rokeithu/-Ball-Sorting-Mechanical-Arm/FULLASSEMBLY.SLDASM

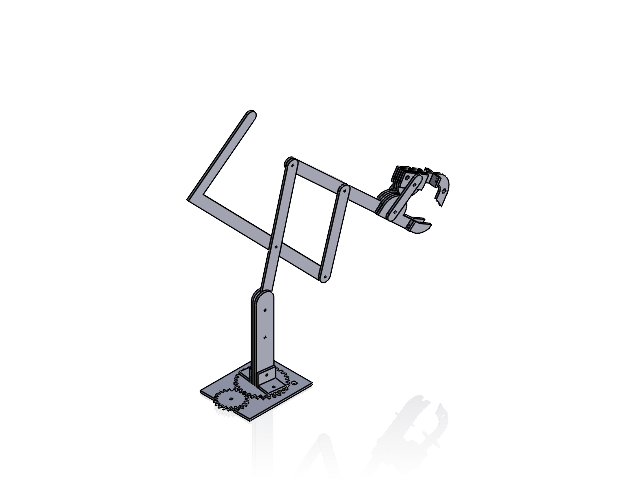
[picture p7: CAD file, 2025-09-13]
FULLASSEMBLY.SLDASM
Base
Gear
Arm Gear
skinny base x 2
skinny part 2
skinny part 3
skinny part 4
Skinny Part5 (2)
blockthing x 4
BottomClawLink
V2BottomClaw x 2
Gear Spacer x 4
TopClaw
V2BottomClawSpacer x 2
BracketOne x 2
TopClawLink
