rokeithu/-Ball-Sorting-Mechanical-Arm/(list of files, cad)

Other CAD files:
ARM TO BASE BLOCK.SLDDRW
ArmAssembly.SLDDRW
ArmToBase.SLDDRW
Base.SLDDRW
BaseAssembly.SLDDRW
BottomClawLink.SLDDRW
Claw.SLDDRW
ClawLinkage.SLDDRW
FourBarLinkageHandle.SLDDRW
FourBarLinkageOne.SLDDRW
FourBarLinkageToClam.SLDDRW
FourBarLinkageTwo.SLDDRW
GearOne.SLDDRW
GearTwo.SLDDRW
TopClaw.SLDDRW
TopClawLink.SLDDRW
V2BottomClaw.SLDDRW
V2BottomClawSpacer.SLDDRW
crank.SLDDRW
