rokeithu/-Ball-Sorting-Mechanical-Arm/ArmAssembly.pdf

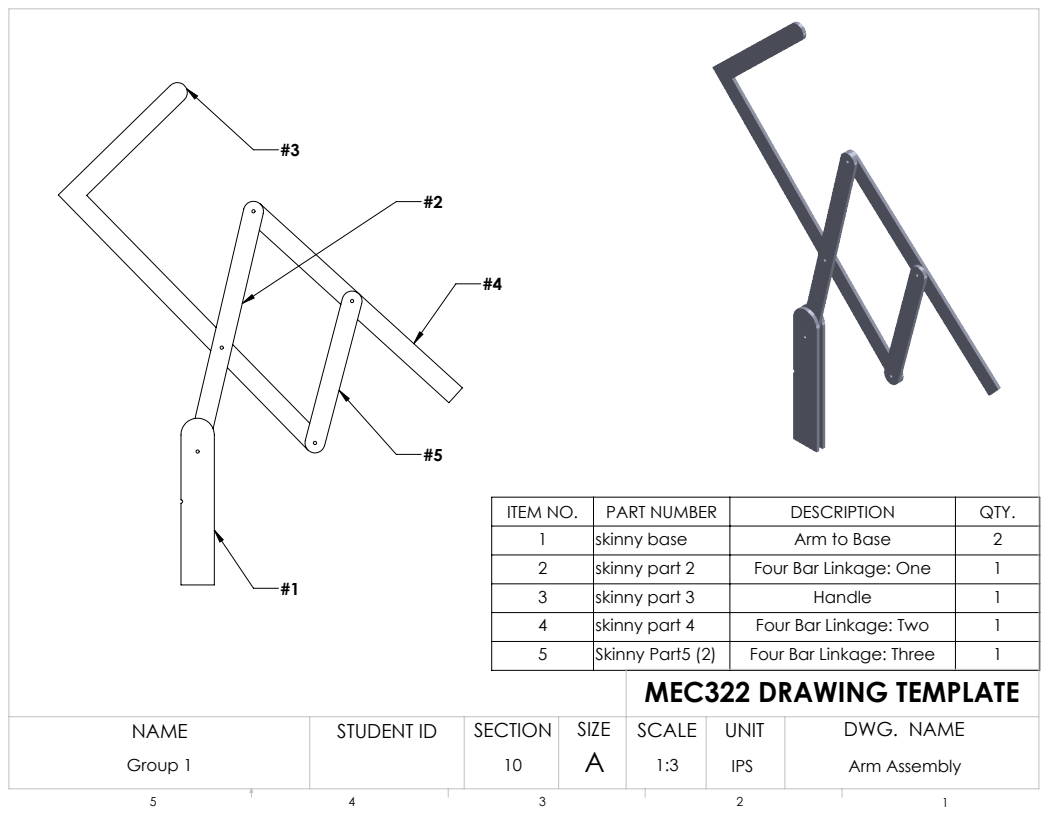
[picture p8: page 1]
MEC322 DRAWING TEMPLATE; NAME; STUDENT ID; SECTION; SCALE UNIT; DWG. NAME; Group 1; IPS; Arm Assembly

ITEM NO. | PART NUMBER | DESCRIPTION | QTY.
1 | skinny base | Arm to Base | 2
2 | skinny part 2 | Four Bar Linkage: One | 1
3 | skinny part 3 | Handle | 1
4 | skinny part 4 | Four Bar Linkage: Two | 1
5 | Skinny Part5 (2) | Four Bar Linkage: Three | 1
