rokeithu/-Ball-Sorting-Mechanical-Arm/BaseAssembly.pdf

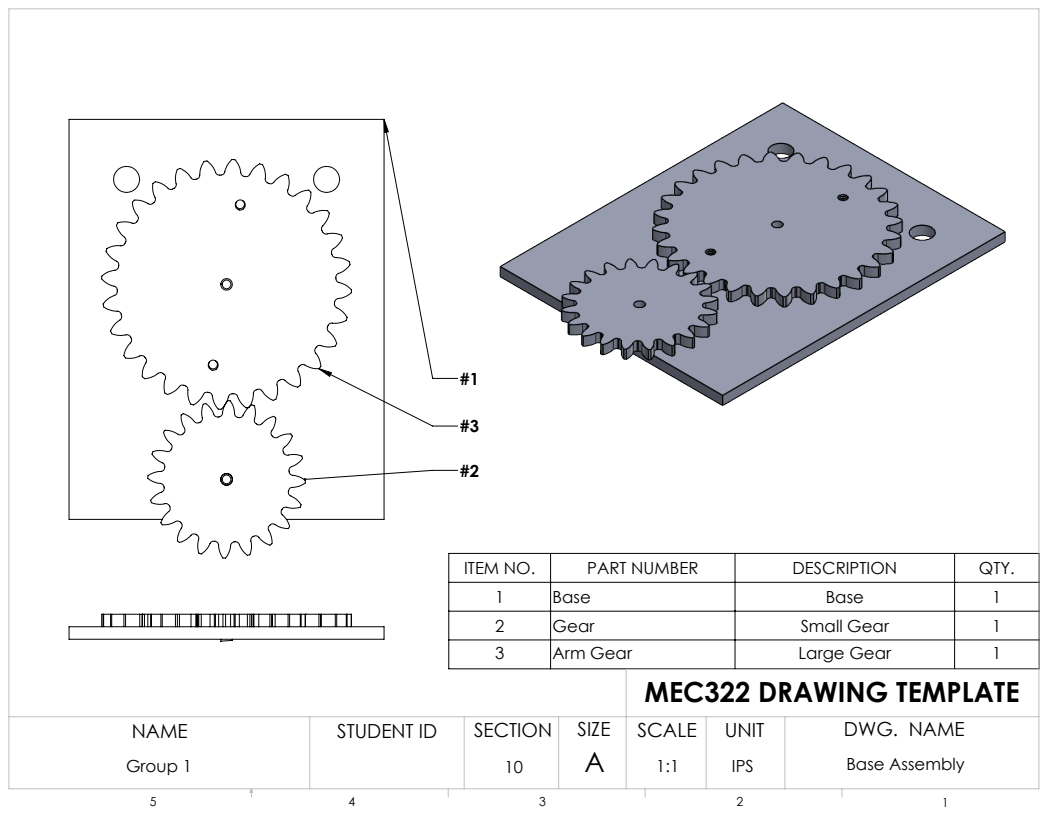
[picture p9: page 1]
MEC322 DRAWING TEMPLATE; NAME; STUDENT ID; SECTION; SCALE UNIT; DWG. NAME; Group 1; IPS; Base Assembly

ITEM NO. | PART NUMBER | DESCRIPTION | QTY.
1 | Base | Base | 1
2 | Gear | Small Gear | 1
3 | Arm Gear | Large Gear | 1
