rokeithu/-Ball-Sorting-Mechanical-Arm/BottomClawLink.pdf

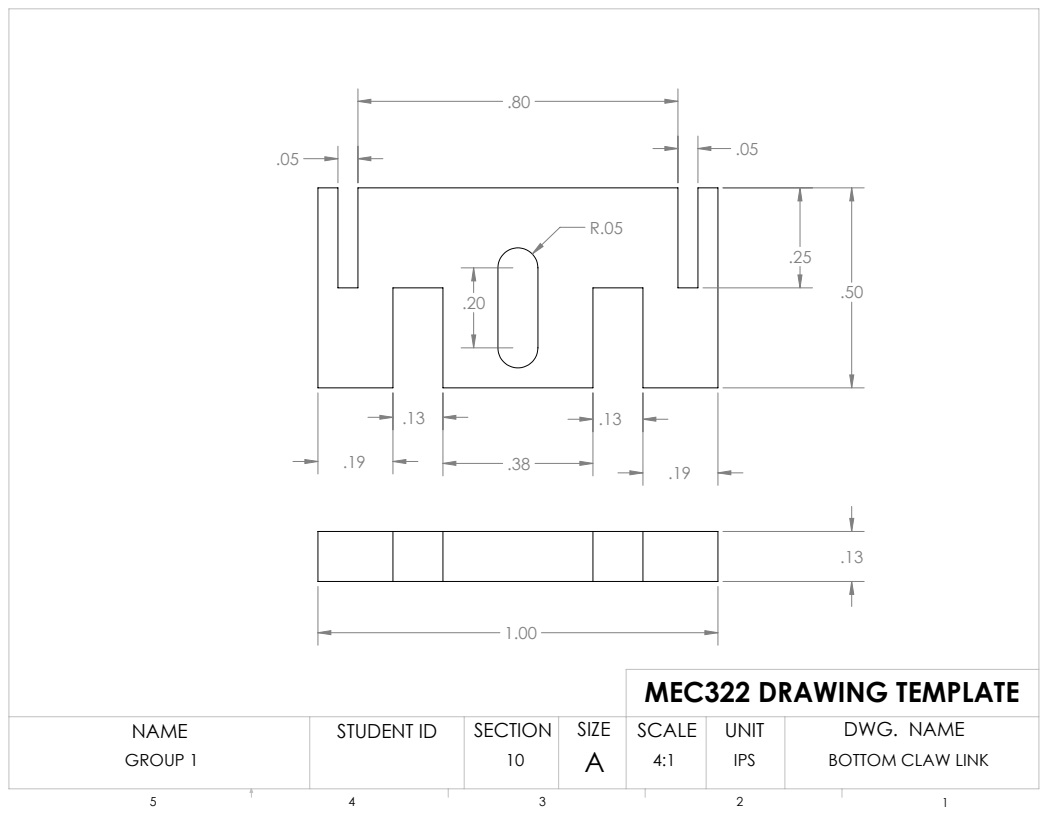
[picture p10: page 1]
MEC322 DRAWING TEMPLATE; NAME; STUDENT ID; SECTION; SCALE UNIT; DWG. NAME; GROUP 1; IPS; BOTTOM CLAW LINK
