rokeithu/-Ball-Sorting-Mechanical-Arm/ClawLinkage.pdf

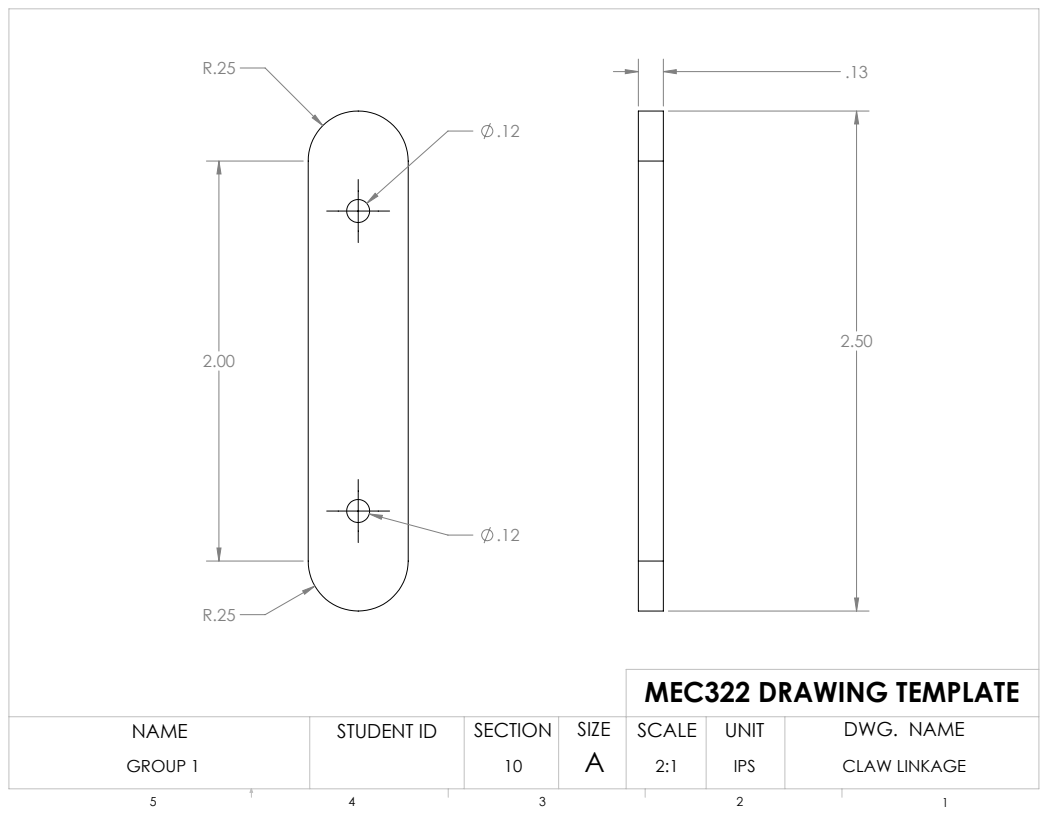
[picture p11: page 1]
MEC322 DRAWING TEMPLATE; NAME; STUDENT ID; SECTION; SCALE UNIT; DWG. NAME; GROUP 1; IPS; CLAW LINKAGE
