rokeithu/-Ball-Sorting-Mechanical-Arm/FourBarLinkageToClam.pdf

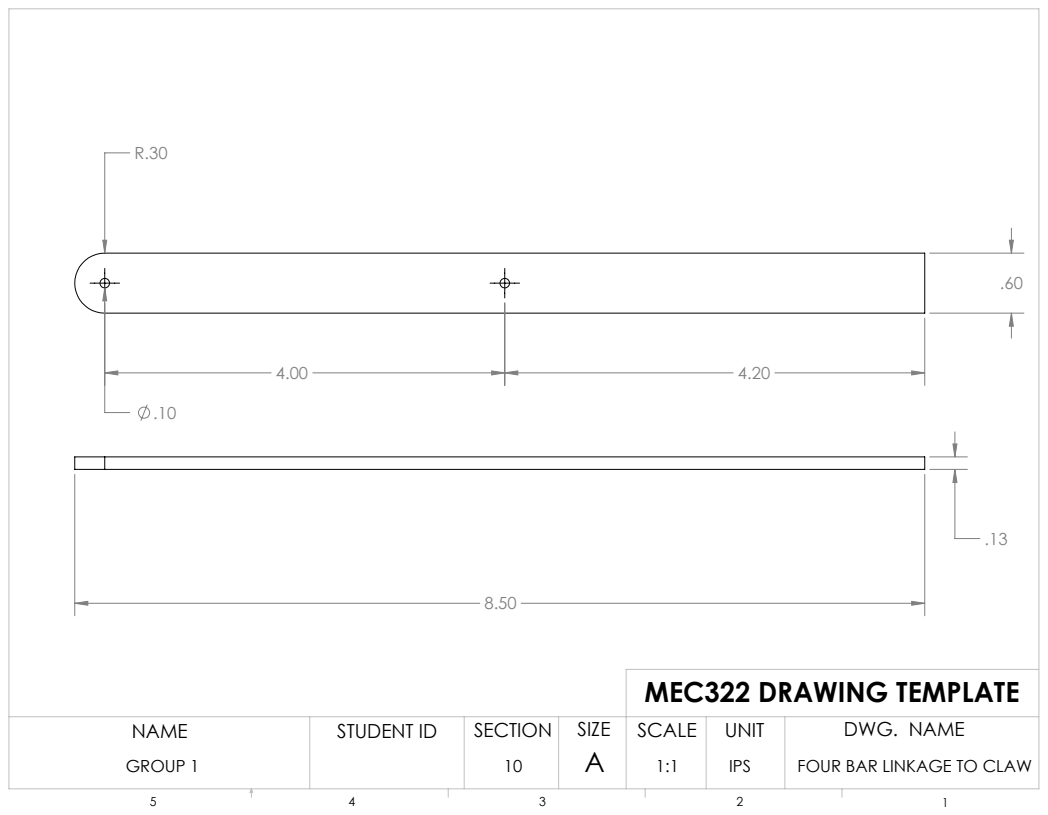
[picture p12: page 1]
MEC322 DRAWING TEMPLATE; NAME; STUDENT ID; SECTION; SCALE UNIT; DWG. NAME; GROUP 1; IPS; FOUR BAR LINKAGE TO CLAW
