rokeithu/-Ball-Sorting-Mechanical-Arm/GearOne.pdf

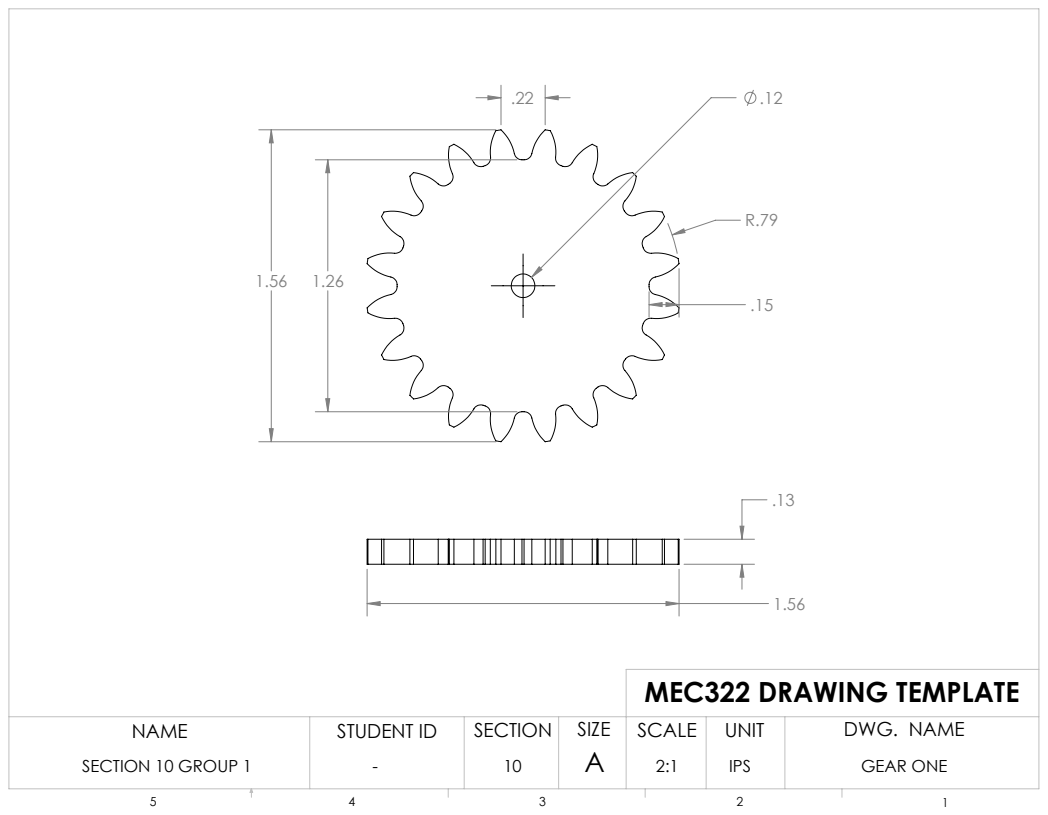
[picture p13: page 1]
MEC322 DRAWING TEMPLATE; NAME; STUDENT ID; SECTION; SCALE UNIT; DWG. NAME; SECTION 10 GROUP 1; IPS; GEAR ONE
