rokeithu/-Ball-Sorting-Mechanical-Arm/GearTwo.pdf

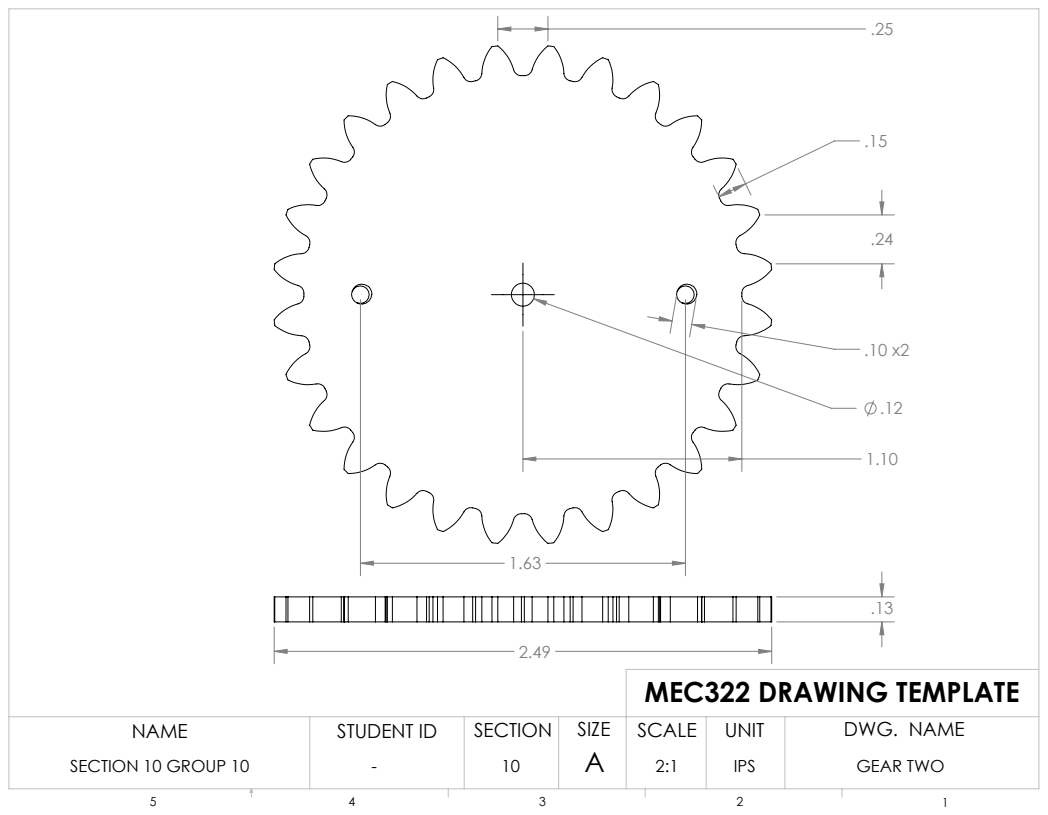
[picture p14: page 1]
MEC322 DRAWING TEMPLATE; NAME; STUDENT ID; SECTION; SCALE UNIT; DWG. NAME; SECTION 10 GROUP 10; IPS; GEAR TWO
