rokeithu/-Ball-Sorting-Mechanical-Arm/TopClaw.pdf

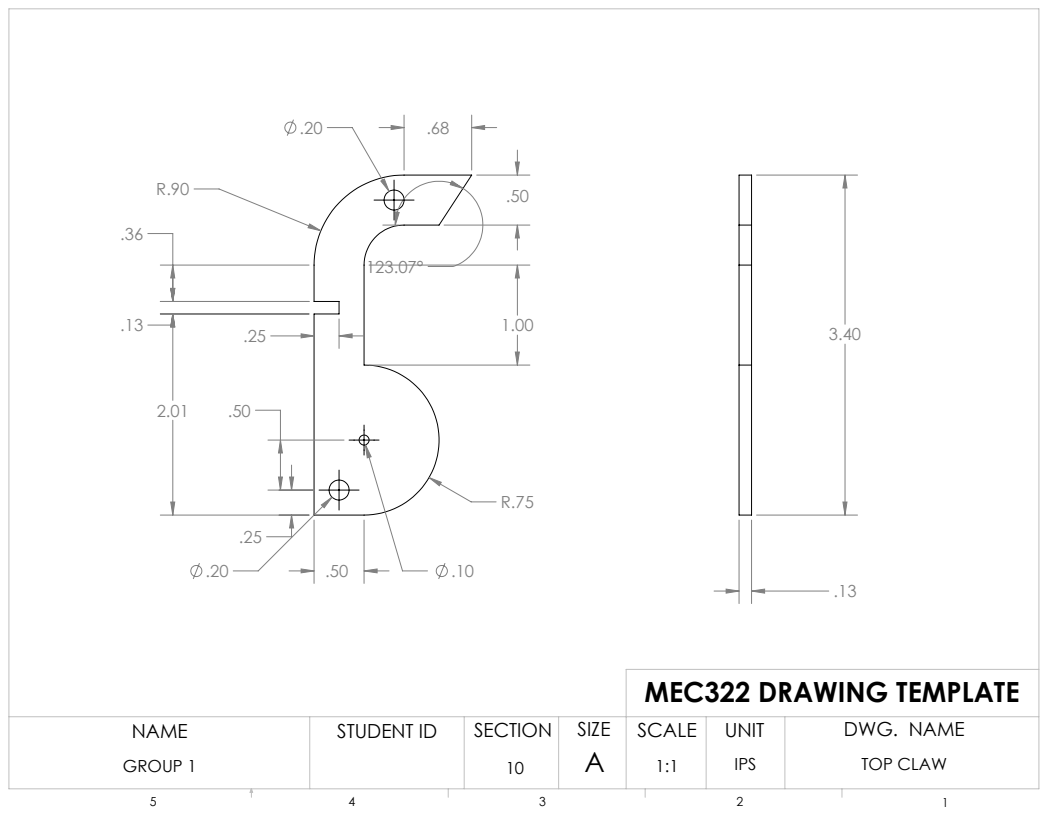
[picture p15: page 1]
MEC322 DRAWING TEMPLATE; NAME; STUDENT ID; SECTION; SCALE UNIT; DWG. NAME; GROUP 1; IPS; TOP CLAW
