rokeithu/-Ball-Sorting-Mechanical-Arm/Claw.pdf

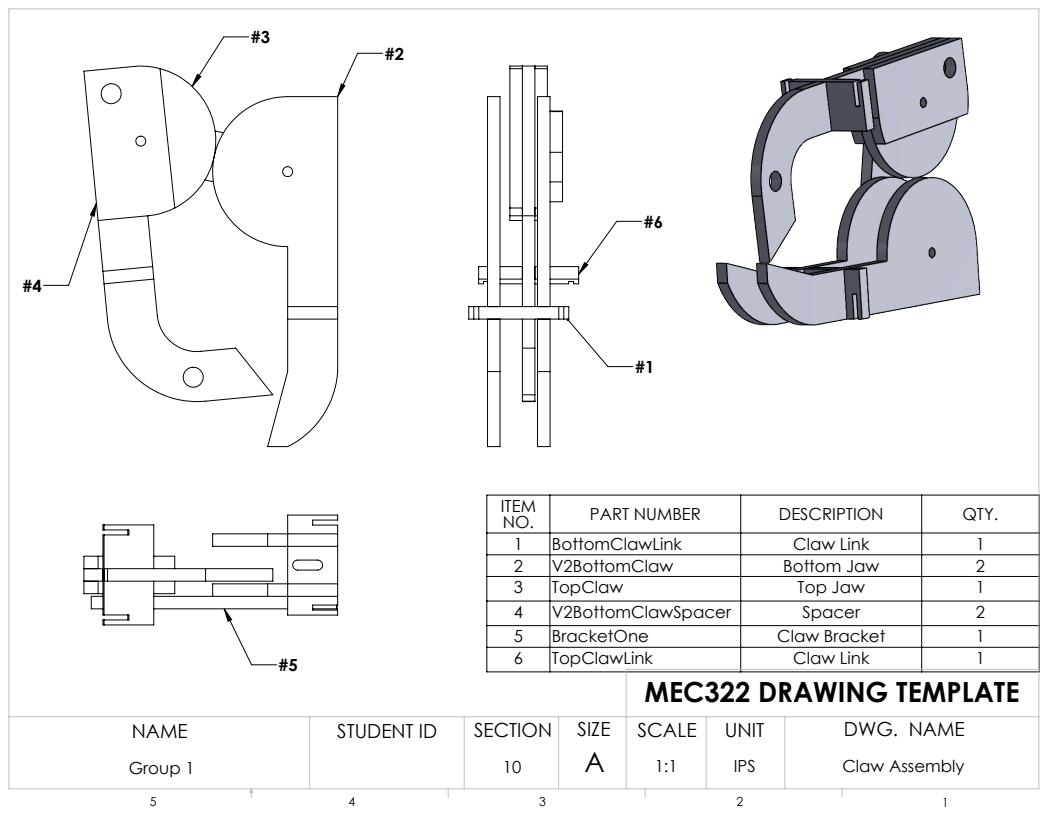
[picture p17: page 1]
MEC322 DRAWING TEMPLATE; NAME; STUDENT ID; SECTION; SCALE UNIT; DWG. NAME; Group 1; IPS; Claw Assembly

ITEM NO. | PART NUMBER | DESCRIPTION | QTY.
1 | BottomClawLink | Claw Link | 1
2 | V2BottomClaw | Bottom Jaw | 2
3 | TopClaw | Top Jaw | 1
4 | V2BottomClawSpacer | Spacer | 2
5 | BracketOne | Claw Bracket | 1
6 | TopClawLink | Claw Link | 1
