rokeithu/-Ball-Sorting-Mechanical-Arm/Base.pdf

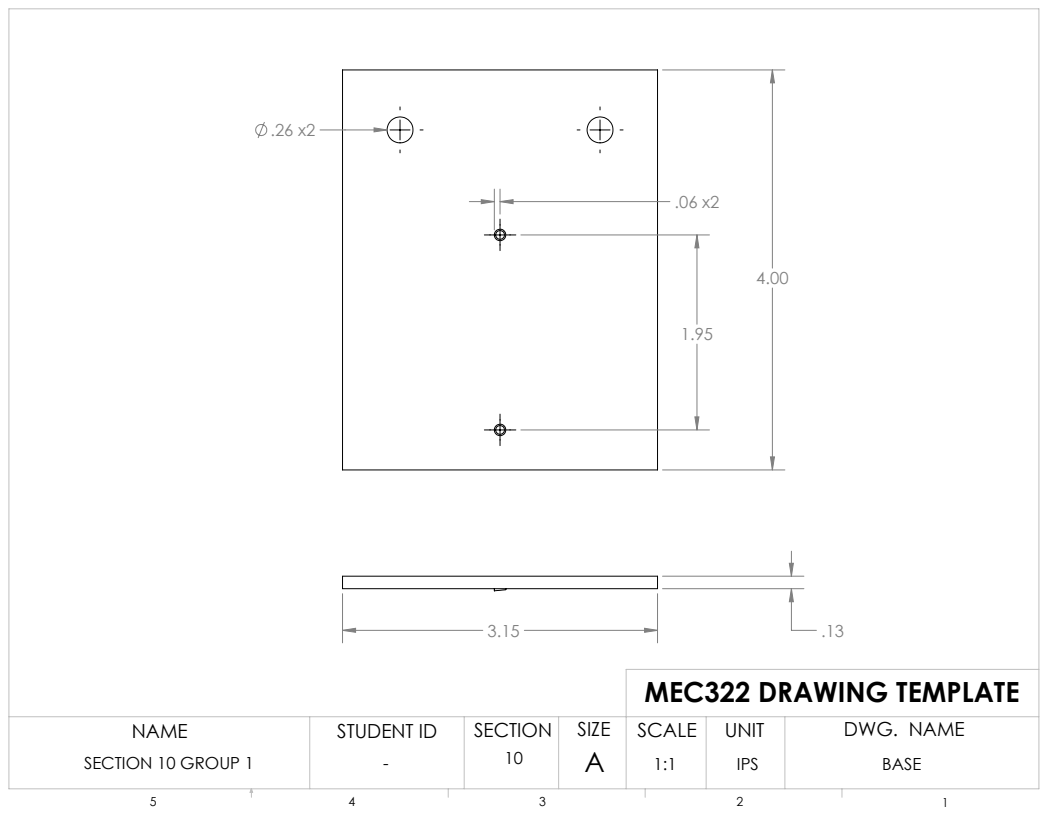
[picture p18: page 1]
SECTION 10 GROUP 1; IPS; BASE 10; MEC322 DRAWING TEMPLATE; NAME; STUDENT ID; SECTION; SCALE UNIT; DWG. NAME
