rokeithu/-Ball-Sorting-Mechanical-Arm/crank.pdf

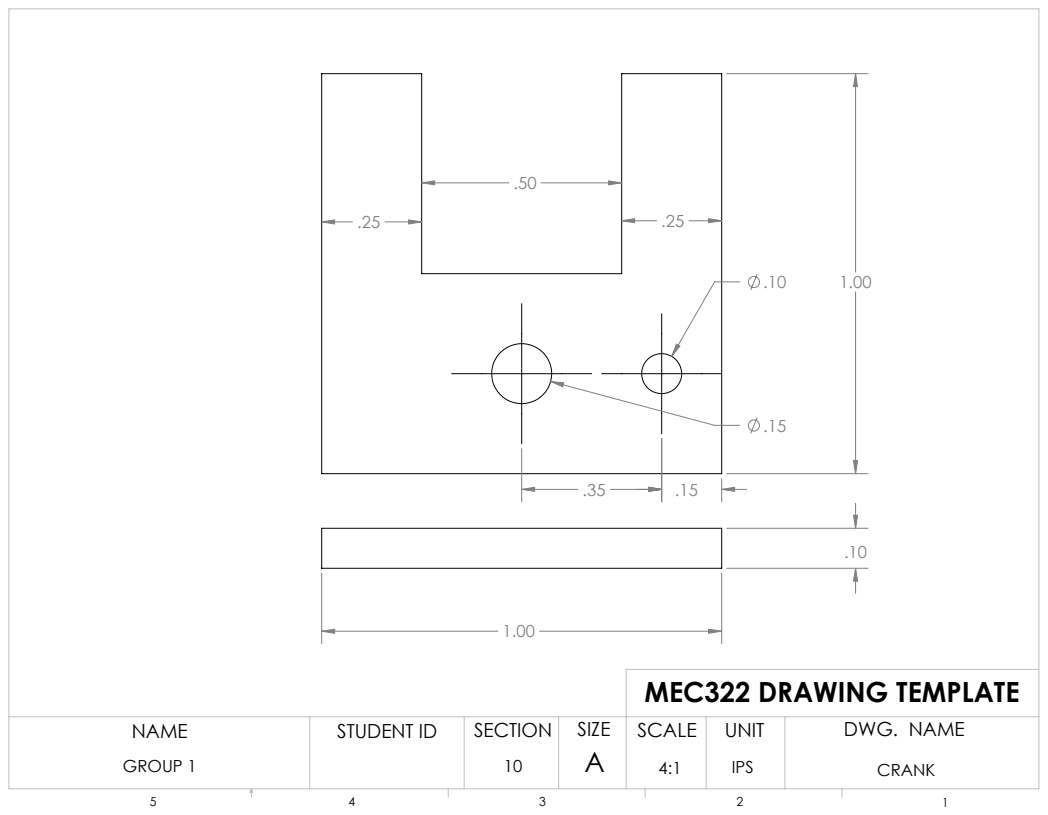
[picture p19: page 1]
MEC322 DRAWING TEMPLATE; NAME; STUDENT ID; SECTION; SCALE UNIT; DWG. NAME; GROUP 1; IPS; CRANK
